nswathi/DigitalUrimeter/static/EKG.gif

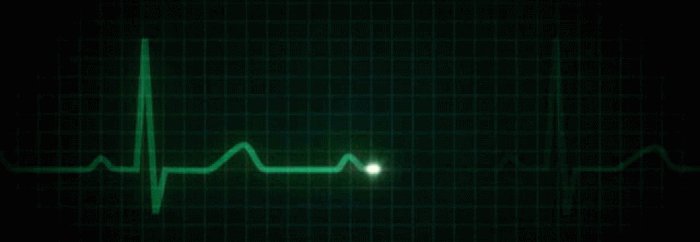
static/EKG.gif
